mystster/ErgoNexus/ErgoNexus.kicad_pcb

## KiCad design ErgoNexus.kicad_pcb (2026-05-21)

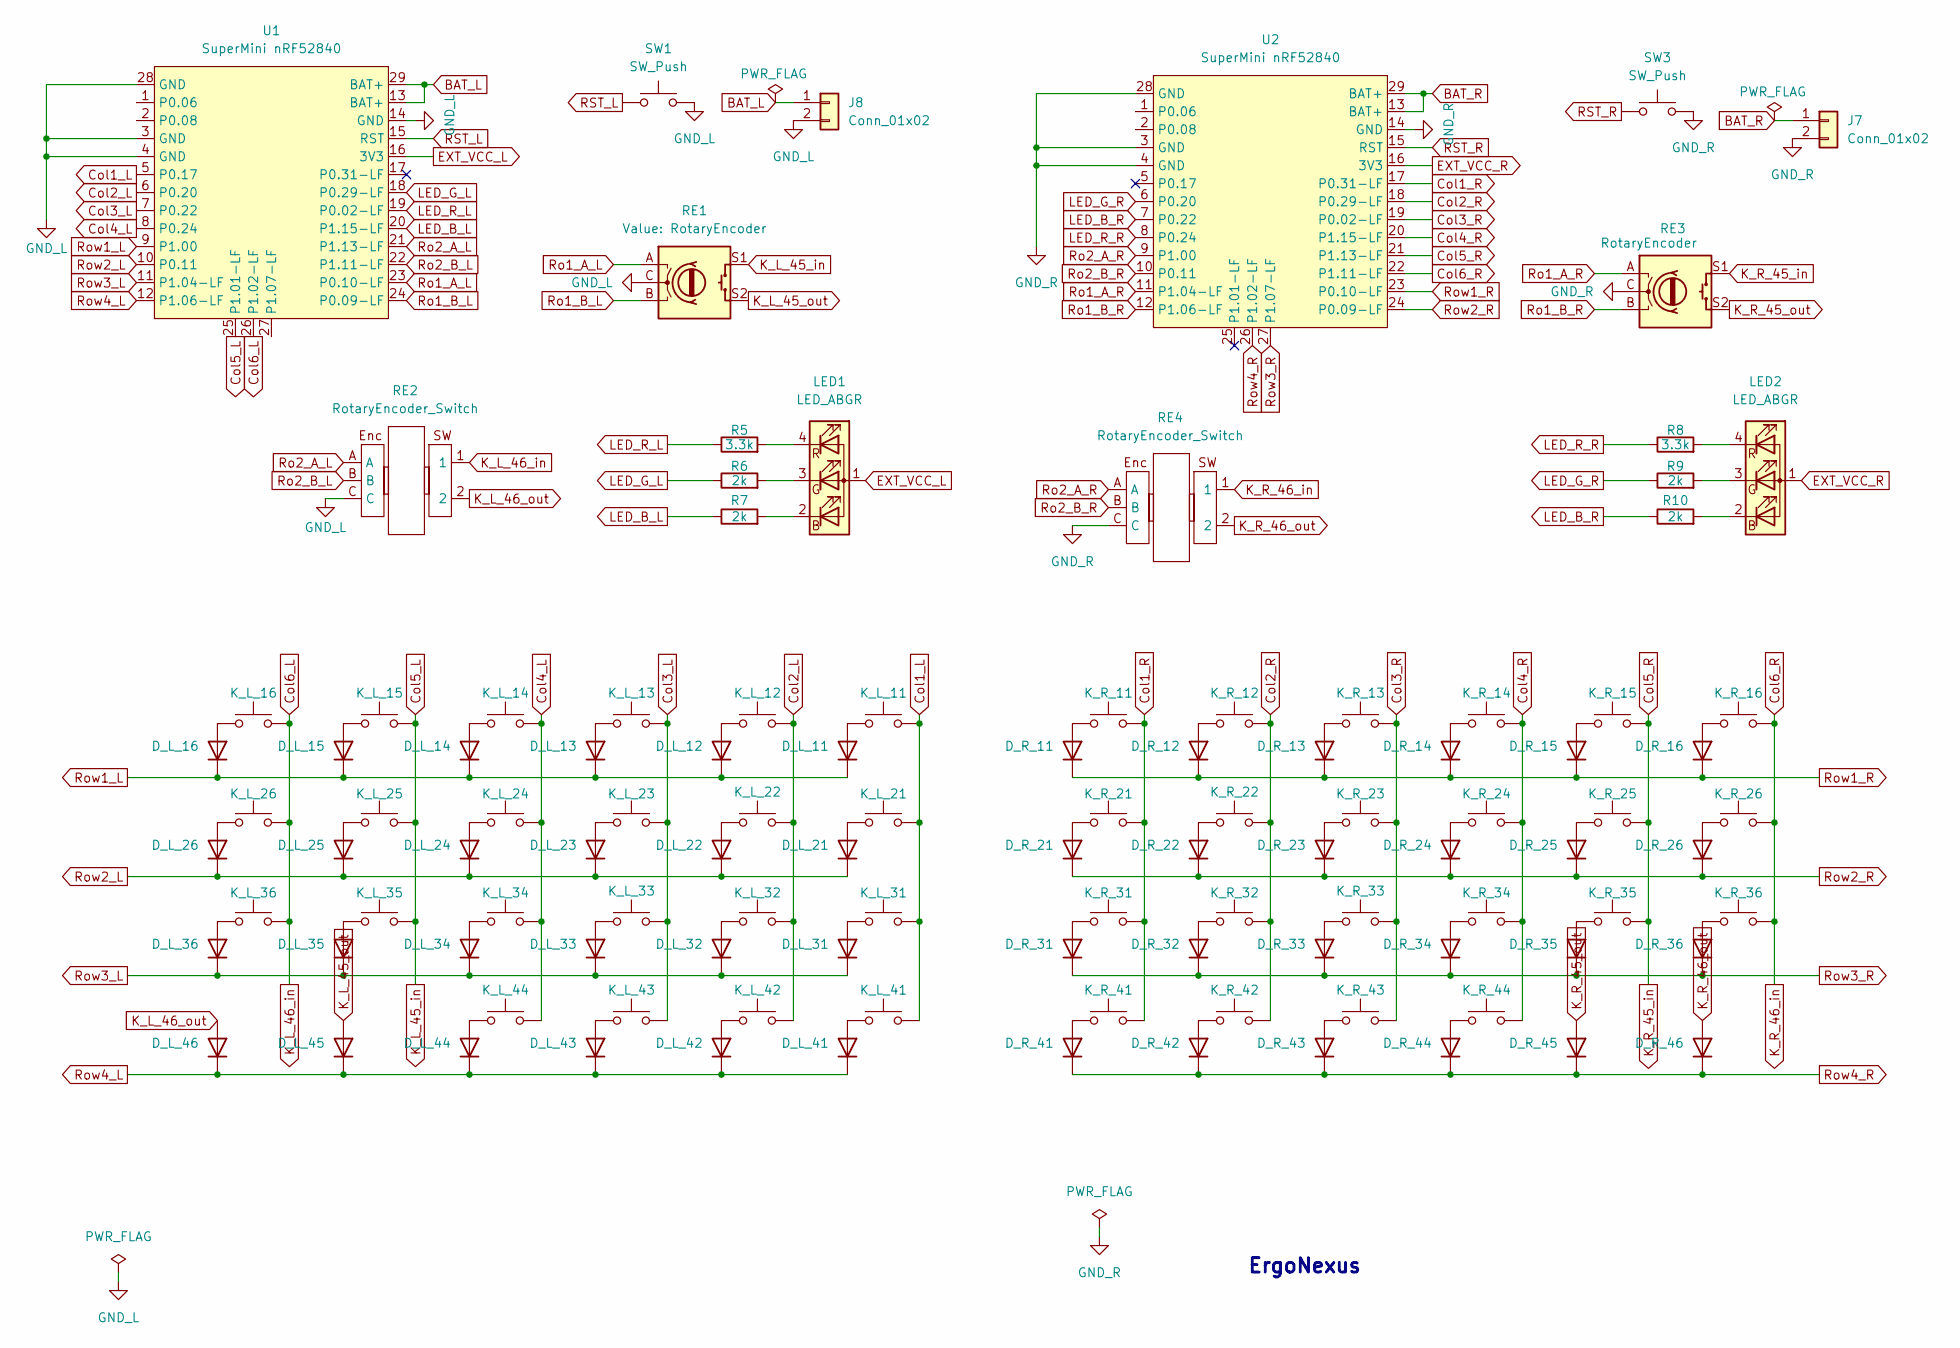
[picture p1: schematic ErgoNexus.kicad_sch]

Parts:
D_L_11, D_L_12, D_L_13, D_L_14, D_L_15, D_L_16, D_L_21, D_L_22, D_L_23, D_L_24, D_L_25, D_L_26, D_L_31, D_L_32, D_L_33, D_L_34, D_L_35, D_L_36, D_L_41, D_L_42, D_L_43, D_L_44, D_L_45, D_L_46: 1N4148SW; D_SOD-323; LCSC C2128
D_R_11, D_R_12, D_R_13, D_R_14, D_R_15, D_R_16, D_R_21, D_R_22, D_R_23, D_R_24, D_R_25, D_R_26, D_R_31, D_R_32, D_R_33, D_R_34, D_R_35, D_R_36, D_R_41, D_R_42, D_R_43, D_R_44, D_R_45, D_R_46: 1N4148SW; D_SOD-323; LCSC C2128
J7, J8: Conn_01x02; JST_PH_S2B-PH-K_1x02_P2.00mm_Horizontal
K_L_11, K_L_12, K_L_13, K_L_14, K_L_15, K_L_16, K_L_21, K_L_22, K_L_23, K_L_24, K_L_25, K_L_26, K_L_31, K_L_32, K_L_33, K_L_34, K_L_35, K_L_36, K_L_41, K_L_42, K_L_43, K_L_44: SW_Push; GatronLP_Hotswap_1u
K_R_11, K_R_12, K_R_13, K_R_14, K_R_15, K_R_16, K_R_21, K_R_22, K_R_23, K_R_24, K_R_25, K_R_26, K_R_31, K_R_32, K_R_33, K_R_34, K_R_35, K_R_36, K_R_41, K_R_42, K_R_43, K_R_44: SW_Push; GatronLP_Hotswap_1u
LED1, LED2: LED_ABGR; LED Rectangle(OSTBMAZ2C1D)
R5, R8: 3.3k; R_0402; LCSC C25890
R6, R7, R9, R10: 2k; R_0402; LCSC C4109
RE1, RE3: RotaryEncoder; RotaryEncoder_EC11
RE2, RE4: RotaryEncoder_Switch; THQWGD001C [2pin] #2
SW1, SW3: SW_Push; ResetSW
U1, U2: SuperMini nRF52840; SuperMini_nRF52840_AH_USBup

Connections:
BAT_L: J8.1, U1.13 (BAT+), U1.29 (BAT+)
BAT_R: J7.1, U2.13 (BAT+), U2.29 (BAT+)
Col1_L: K_L_11.1, K_L_21.1, K_L_31.1, K_L_41.1, U1.5 (P0.17)
Col1_R: K_R_11.1, K_R_21.1, K_R_31.1, K_R_41.1, U2.17 (P0.31-LF)
Col2_L: K_L_12.1, K_L_22.1, K_L_32.1, K_L_42.1, U1.6 (P0.20)
Col2_R: K_R_12.1, K_R_22.1, K_R_32.1, K_R_42.1, U2.18 (P0.29-LF)
Col3_L: K_L_13.1, K_L_23.1, K_L_33.1, K_L_43.1, U1.7 (P0.22)
Col3_R: K_R_13.1, K_R_23.1, K_R_33.1, K_R_43.1, U2.19 (P0.02-LF)
Col4_L: K_L_14.1, K_L_24.1, K_L_34.1, K_L_44.1, U1.8 (P0.24)
Col4_R: K_R_14.1, K_R_24.1, K_R_34.1, K_R_44.1, U2.20 (P1.15-LF)
Col5_L: K_L_15.1, K_L_25.1, K_L_35.1, RE1.S1, U1.25 (P1.01-LF)
Col5_R: K_R_15.1, K_R_25.1, K_R_35.1, RE3.S1, U2.21 (P1.13-LF)
Col6_L: K_L_16.1, K_L_26.1, K_L_36.1, RE2.1, U1.26 (P1.02-LF)
Col6_R: K_R_16.1, K_R_26.1, K_R_36.1, RE4.1, U2.22 (P1.11-LF)
EXT_VCC_L: LED1.1 (A), U1.16 (3V3)
EXT_VCC_R: LED2.1 (A), U2.16 (3V3)
GND_L: J8.2, RE1.C, RE2.C, SW1.2, U1.3 (GND), U1.4 (GND), U1.14 (GND), U1.28 (GND)
GND_R: J7.2, RE3.C, RE4.C, SW3.2, U2.3 (GND), U2.4 (GND), U2.14 (GND), U2.28 (GND)
K_L_45_out: D_L_45.2 (A), RE1.S2
K_L_46_out: D_L_46.2 (A), RE2.2
K_R_45_out: D_R_45.2 (A), RE3.S2
K_R_46_out: D_R_46.2 (A), RE4.2
LED_B_L: R7.1, U1.20 (P1.15-LF)
LED_B_R: R10.1, U2.7 (P0.22)
LED_G_L: R6.1, U1.18 (P0.29-LF)
LED_G_R: R9.1, U2.6 (P0.20)
LED_R_L: R5.1, U1.19 (P0.02-LF)
LED_R_R: R8.1, U2.8 (P0.24)
unnamed: D_L_11.2 (A), K_L_11.2
unnamed: D_L_12.2 (A), K_L_12.2
unnamed: D_L_13.2 (A), K_L_13.2
unnamed: D_L_14.2 (A), K_L_14.2
unnamed: D_L_15.2 (A), K_L_15.2
unnamed: D_L_16.2 (A), K_L_16.2
unnamed: D_L_21.2 (A), K_L_21.2
unnamed: D_L_22.2 (A), K_L_22.2
unnamed: D_L_23.2 (A), K_L_23.2
unnamed: D_L_24.2 (A), K_L_24.2
unnamed: D_L_25.2 (A), K_L_25.2
unnamed: D_L_26.2 (A), K_L_26.2
unnamed: D_L_31.2 (A), K_L_31.2
unnamed: D_L_32.2 (A), K_L_32.2
unnamed: D_L_33.2 (A), K_L_33.2
unnamed: D_L_34.2 (A), K_L_34.2
unnamed: D_L_35.2 (A), K_L_35.2
unnamed: D_L_36.2 (A), K_L_36.2
unnamed: D_L_41.2 (A), K_L_41.2
unnamed: D_L_42.2 (A), K_L_42.2
unnamed: D_L_43.2 (A), K_L_43.2
unnamed: D_L_44.2 (A), K_L_44.2
unnamed: D_R_11.2 (A), K_R_11.2
unnamed: D_R_12.2 (A), K_R_12.2
unnamed: D_R_13.2 (A), K_R_13.2
unnamed: D_R_14.2 (A), K_R_14.2
unnamed: D_R_15.2 (A), K_R_15.2
unnamed: D_R_16.2 (A), K_R_16.2
unnamed: D_R_21.2 (A), K_R_21.2
unnamed: D_R_22.2 (A), K_R_22.2
unnamed: D_R_23.2 (A), K_R_23.2
unnamed: D_R_24.2 (A), K_R_24.2
unnamed: D_R_25.2 (A), K_R_25.2
unnamed: D_R_26.2 (A), K_R_26.2
unnamed: D_R_31.2 (A), K_R_31.2
unnamed: D_R_32.2 (A), K_R_32.2
unnamed: D_R_33.2 (A), K_R_33.2
unnamed: D_R_34.2 (A), K_R_34.2
unnamed: D_R_35.2 (A), K_R_35.2
unnamed: D_R_36.2 (A), K_R_36.2
unnamed: D_R_41.2 (A), K_R_41.2
unnamed: D_R_42.2 (A), K_R_42.2
unnamed: D_R_43.2 (A), K_R_43.2
unnamed: D_R_44.2 (A), K_R_44.2
unnamed: LED1.2 (BK), R7.2
unnamed: LED1.3 (GK), R6.2
unnamed: LED1.4 (RK), R5.2
unnamed: LED2.2 (BK), R10.2
unnamed: LED2.3 (GK), R9.2
unnamed: LED2.4 (RK), R8.2
RST_L: SW1.1, U1.15 (RST)
RST_R: SW3.1, U2.15 (RST)
Ro1_A_L: RE1.A, U1.23 (P0.10-LF)
Ro1_A_R: RE3.A, U2.11 (P1.04-LF)
Ro1_B_L: RE1.B, U1.24 (P0.09-LF)
Ro1_B_R: RE3.B, U2.12 (P1.06-LF)
Ro2_A_L: RE2.A, U1.21 (P1.13-LF)
Ro2_A_R: RE4.A, U2.9 (P1.00)
Ro2_B_L: RE2.B, U1.22 (P1.11-LF)
Ro2_B_R: RE4.B, U2.10 (P0.11)
Row1_L: D_L_11.1 (K), D_L_12.1 (K), D_L_13.1 (K), D_L_14.1 (K), D_L_15.1 (K), D_L_16.1 (K), U1.9 (P1.00)
Row1_R: D_R_11.1 (K), D_R_12.1 (K), D_R_13.1 (K), D_R_14.1 (K), D_R_15.1 (K), D_R_16.1 (K), U2.23 (P0.10-LF)
Row2_L: D_L_21.1 (K), D_L_22.1 (K), D_L_23.1 (K), D_L_24.1 (K), D_L_25.1 (K), D_L_26.1 (K), U1.10 (P0.11)
Row2_R: D_R_21.1 (K), D_R_22.1 (K), D_R_23.1 (K), D_R_24.1 (K), D_R_25.1 (K), D_R_26.1 (K), U2.24 (P0.09-LF)
Row3_L: D_L_31.1 (K), D_L_32.1 (K), D_L_33.1 (K), D_L_34.1 (K), D_L_35.1 (K), D_L_36.1 (K), U1.11 (P1.04-LF)
Row3_R: D_R_31.1 (K), D_R_32.1 (K), D_R_33.1 (K), D_R_34.1 (K), D_R_35.1 (K), D_R_36.1 (K), U2.27 (P1.07-LF)
Row4_L: D_L_41.1 (K), D_L_42.1 (K), D_L_43.1 (K), D_L_44.1 (K), D_L_45.1 (K), D_L_46.1 (K), U1.12 (P1.06-LF)
Row4_R: D_R_41.1 (K), D_R_42.1 (K), D_R_43.1 (K), D_R_44.1 (K), D_R_45.1 (K), D_R_46.1 (K), U2.26 (P1.02-LF)

Notes on the sheet:
ErgoNexus

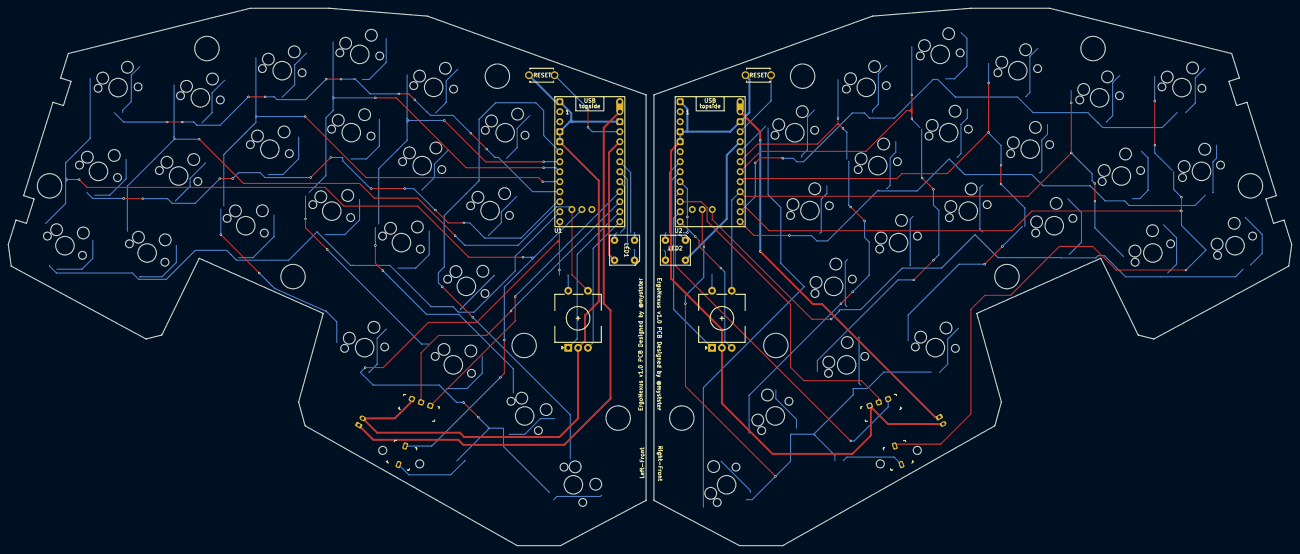
[picture p2: board ErgoNexus.kicad_pcb from above]

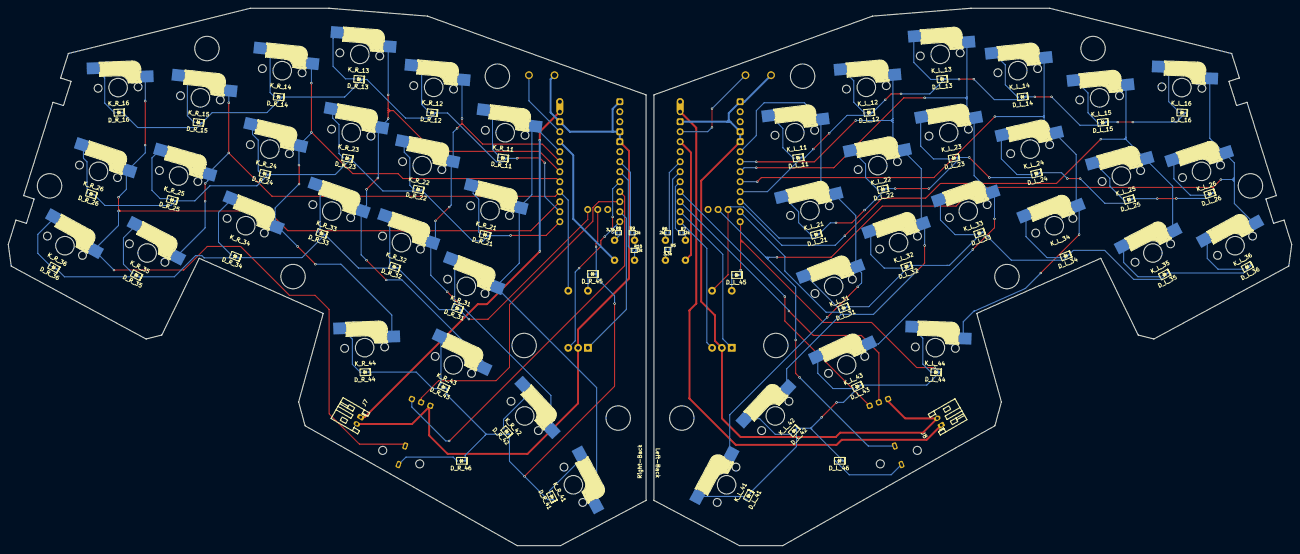
[picture p3: board ErgoNexus.kicad_pcb from below]

Board: 2 copper layers, 326.0 x 136.5 mm, 110 parts (58 on the bottom side), 96 nets.
