mystster/ErgoNexus/(commit log)

2025-06-06 回路図が完成
    [ErgoNexus.kicad_sch, round-robin-7-30.kicad_sch]
2025-06-06 不要なファイルを削除
    [round-robin-7-30.kicad_sch]
2025-06-13 pinアサインの変更 Fixes #1
    [ErgoNexus.kicad_pcb, ErgoNexus.kicad_sch]
2025-06-13 chore: add .gitignore file
    .gitignoreにバックアップファイルと一時ファイルを追加して、リポジトリ内に不要なファイルが含まれないようにしました。
2025-06-14 chore(gitignore): update ignore patterns
    バックアップファイルと一時ファイルのパターンを追加しました。
2025-06-14 fix: forget spi cs pin
    [ErgoNexus.kicad_sch]
2025-11-10 feat: 右手のレイアウトを設定
    [ErgoNexus.kicad_pcb, keyboard-right.dxf]
2025-11-10 chore: remove Cuts
    [ErgoNexus.kicad_pcb]
2025-11-14 fix: 右手の配線を完成
    [ErgoNexus.kicad_pcb, ErgoNexus.kicad_sch]
2025-11-14 feat: 回路図においてキースイッチをマトリックス配列に変更
    [ErgoNexus.kicad_sch]
2025-11-14 feat: PCBにおいてアノテーションを対応付け
    [ErgoNexus.kicad_pcb]
2025-11-15 fix: not fully annotation
    [ErgoNexus.kicad_sch]
2025-11-15 feat: finish wire for right
    [ErgoNexus.kicad_pcb]
2025-11-16 feat: add screw hole
    [ErgoNexus.kicad_pcb]
2025-11-16 fix: fix oled angle
    [ErgoNexus.kicad_pcb]
2025-11-16 fix: 外形の変更
    [ErgoNexus.kicad_pcb]
2025-11-16 fix: change battery connector rotation
    [ErgoNexus.kicad_pcb]
2025-11-16 chore: add few 3d models
    [ErgoNexus.kicad_pcb]
2025-11-16 fix: change oled rotation
    [ErgoNexus.kicad_pcb]
2025-11-16 fix: battery connector position
    [ErgoNexus.kicad_pcb]
2025-11-16 feat: add copy right to front silk
    [ErgoNexus.kicad_pcb]
2025-12-14 feat: 左手の回路図の配置を修正
    [ErgoNexus.kicad_pcb, ErgoNexus.kicad_sch]
2025-12-19 feat: 左手の配線完了
    [ErgoNexus.kicad_pcb, ErgoNexus.kicad_sch]
2025-12-19 chore: jlcpcb向けのデータを出力
    [bom.csv, designators.csv, positions.csv]
2025-12-24 fix: 左右のキーボードを合わせることで、jlcpcb向けデータが正しく出力されるように
    [ErgoNexus.kicad_pcb, bom.csv, designators.csv, positions.csv]
2025-12-24 feat: フィレットとVカットの追加
    [ErgoNexus.kicad_pcb]
2025-12-24 fix: ネジ穴を調整
    [ErgoNexus.kicad_pcb]
2026-03-14 feat: remove one key and oled. little finger place update
    [ErgoNexus.kicad_pcb, ErgoNexus.kicad_sch]
2026-04-12 feat: 右側の配線完了
    [ErgoNexus.kicad_pcb, ErgoNexus.kicad_sch]
2026-04-17 feat: ケース用の回路図などを追加
    [ErgoNexus_outline.kicad_pcb, ErgoNexus_outline.kicad_sch]
2026-04-26 feat: 基板形状の変更
    [ErgoNexus.kicad_pcb]
2026-04-29 feat: 左側の配線が完了
    [ErgoNexus.kicad_pcb, ErgoNexus.kicad_sch]
2026-04-29 fix: キーソケットをGatronLP(KS-33B)用に変更
    [ErgoNexus.kicad_pcb, ErgoNexus.kicad_sch]
2026-05-03 feat: add mouse bites
    [ErgoNexus.kicad_pcb]
2026-05-04 feat: add tooling holes and fiducials
    [ErgoNexus.kicad_pcb]
2026-05-05 feat: 水平ロータリーエンコーダのスイッチ部品を変更
    元々の11mmだと高すぎるのでエンコーダを7mmに変更。
    それに伴い、switchも高さの低いものに変更する必要があり、フットプリントを変更
    [ErgoNexus.kicad_pcb, ErgoNexus.kicad_sch]
2026-05-06 chore: remove unused files
    [ErgoNexus_outline.kicad_pcb, ErgoNexus_outline.kicad_sch]
2026-05-06 feat: change rotary encoder position
    [ErgoNexus.kicad_pcb]
2026-05-11 feat: 水平ロータリーエンコーダの向きを変更
    [ErgoNexus.kicad_sch]
2026-05-11 feat: 親指キーを少し上に変更
    [ErgoNexus.kicad_pcb]
2026-05-14 fix: ルールチェックエラーの修正
    [ErgoNexus.kicad_pcb]
2026-05-16 refactor: clean up
    [bom.csv, designators.csv, keyboard-right.dxf, positions.csv]
2026-05-16 feat: remove mousebites and frame
    [ErgoNexus.kicad_pcb]
2026-05-16 feat: add mousebite and frame using kikit
    [ErgoNexus_kikit.kicad_pcb]
2026-05-17 feat: add assembly info and fix diode footprint
    [BOM-ErgoNexus_kikit.csv, ErgoNexus.kicad_pcb, ErgoNexus.kicad_sch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]
2026-05-17 fix: 線の位置を調整
    [ErgoNexus.kicad_pcb, ErgoNexus_kikit.kicad_pcb]
2026-05-20 fix: remove tooling holes
    [ErgoNexus_kikit.kicad_pcb]
2026-05-21 feat: 端に磁石用の切り込みを追加
    [ErgoNexus.kicad_pcb, ErgoNexus_kikit.kicad_pcb]
2026-05-30 feat: add gerber files.
    [BOM-ErgoNexus_kikit.csv, ErgoNexus_kikit.kicad_pcb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]
2026-05-30 refactor: remove unused files
    [ErgoNexus_kikit-CuBottom.gbr, ErgoNexus_kikit-CuTop.gbr, ErgoNexus_kikit-EdgeCuts.gbr, ErgoNexus_kikit-MaskBottom.gbr, ErgoNexus_kikit-MaskTop.gbr, ErgoNexus_kikit-NPTH.drl, ErgoNexus_kikit-PTH.drl, ErgoNexus_kikit-PasteBottom.gbr]
